geedubs/teensytrigger/pics/IMG_5148.JPG

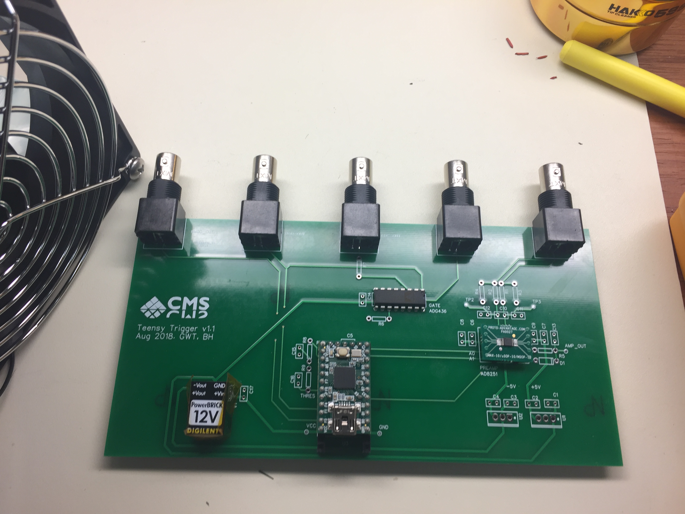
pics/IMG_5148.JPG
