geedubs/teensytrigger/pics/ringdowns.jpg

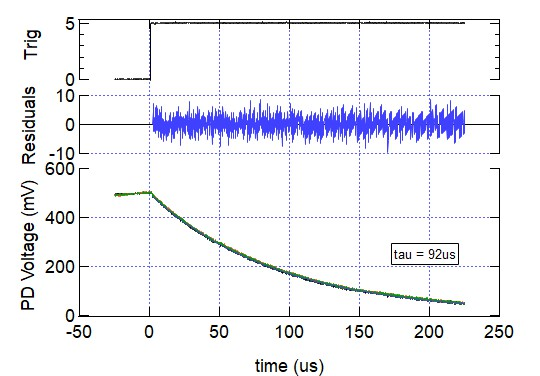
pics/ringdowns.jpg
