geedubs/teensytrigger/pics/top.PNG

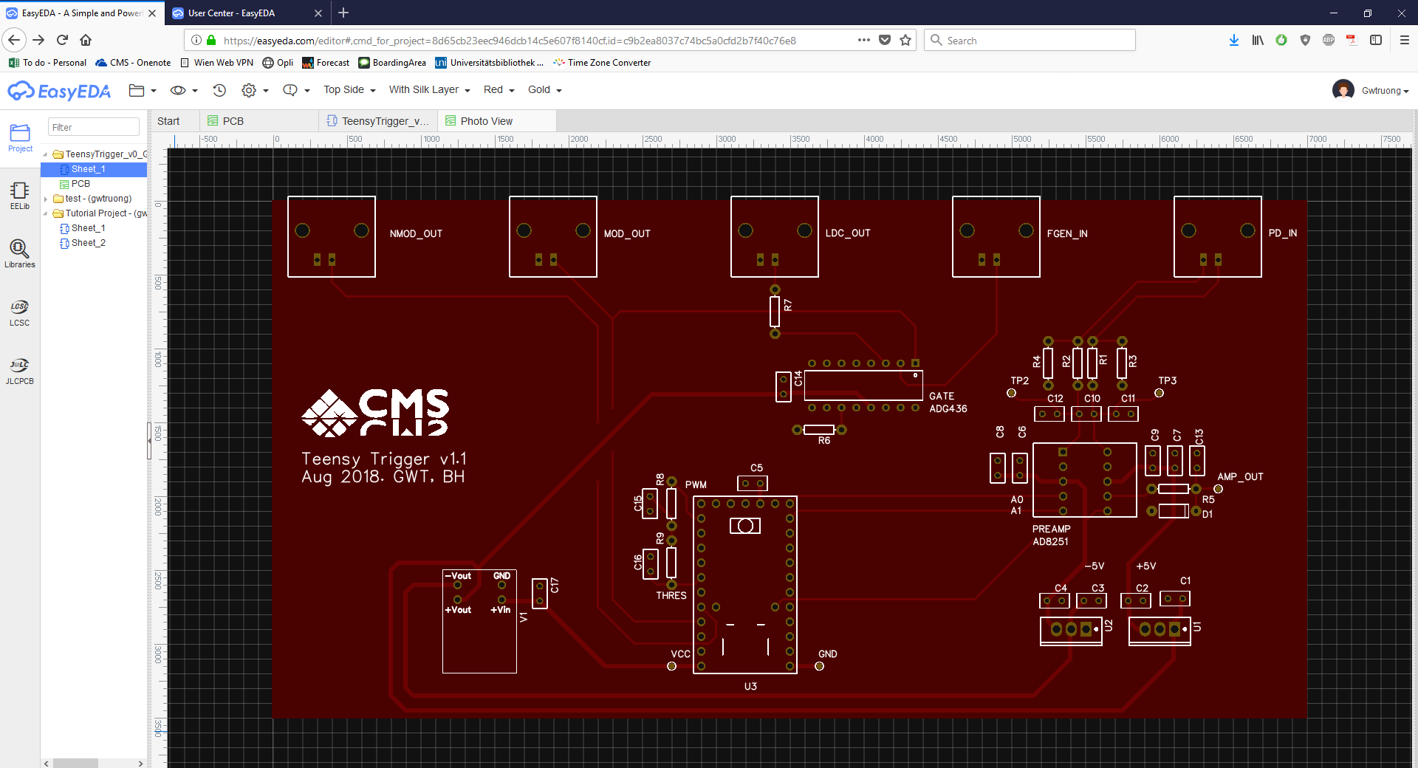
pics/top.PNG
