geedubs/teensytrigger/hardware/BOM.xlsx

QTY | UNIT PRICE | TOTAL PRICE | DESCRIPTION | VENDOR
5 | $2.96 | $14.81 | Custom PCB | See documentation
1 | $16.00 | $16.00 | Teensy 2.0 Microcontroller with pins | https://www.pjrc.com/store/teensy_pins.html
1 | $7.55 | $7.55 | ADG436BN SPDT | https://www.digikey.com/product-detail/en/analog-devices-inc/ADG436BNZ/ADG436BNZ-ND/820072
1 | $11.01 | $11.01 | AD8251 Instrument Amp | https://www.digikey.com/product-detail/en/analog-devices-inc/AD8251ARMZ/AD8251ARMZ-ND/1644799
1 | $19.11 | $19.11 | Digilent 12V PowerBRICK | https://www.digikey.com/product-detail/en/digilent-inc/410-293-A/1286-1106-ND/5730863
1 | $1.54 | $1.54 | LM7805 +5V Linear Reg | https://www.digikey.com/product-detail/en/texas-instruments/LM7805CT-NOPB/296-47192-ND/3901929
1 | $1.63 | $1.63 | LM7905 -5V Linear Reg | https://www.digikey.com/product-detail/en/texas-instruments/LM7905CT-NOPB/LM7905CTNS-NOPB-ND/6349
1 | $16.02 | $16.02 | Project box | https://www.digikey.com/products/en?keywords=HM617-ND
5 | $1.53 | $7.65 | PCB BNC connectors | https://www.digikey.com/products/en?keywords=WM5514-ND
1 | $3.95 | $3.95 | Micro-USB to USB-B panel mount | https://www.digikey.com/products/en?keywords=1528-1573-ND
1 | $4.09 | $4.09 | Surface mount to DIP adapter | https://www.digikey.com/product-detail/en/aries-electronics/LCQT-MSOP10/A881AR-ND/4754589
2 | $0.32 | $0.64 | 2POS Female Header | https://www.digikey.com/product-detail/en/sullins-connector-solutions/PPTC021LFBN-RC/S7000-ND/810142
2 | $0.45 | $0.90 | 4POS Female Header | https://www.digikey.com/product-detail/en/sullins-connector-solutions/PPPC041LFBN-RC/S7037-ND/810176
2 | $0.61 | $1.22 | 7POS Female Header | https://www.digikey.com/product-detail/en/sullins-connector-solutions/PPPC071LFBN-RC/S7040-ND/810179
1 | $0.47 | $0.47 | 5POS Female Header | https://www.digikey.com/product-detail/en/sullins-connector-solutions/PPTC051LFBN-RC/S6103-ND/807239
1 | $0.52 | $0.52 | 2x5pin dip socket | https://www.digikey.com/product-detail/en/on-shore-technology-inc/SA103000/ED3069-5-ND/3935340
3 | $0.63 | $1.89 | 2.2 uF cap (tant C1, C3, C17) | https://www.digikey.com/product-detail/en/avx-corporation/TAP225K016CCS/478-8819-ND/1471492
6 | $0.63 | $3.78 | 0.1 uF cap (tant C2, C4, C5, C6, C7, C14) | https://www.digikey.com/product-detail/en/avx-corporation/TAP104K035SRW/478-11084-1-ND/7536240
2 | $0.10 | $0.20 | 330 Ohm resistor (0.25W R6, R7) | https://www.digikey.com/product-detail/en/stackpole-electronics-inc/CF14JT330R/CF14JT330RCT-ND/1830338
2 | $0.10 | $0.20 | 3.3k resistor (0.25W R8 R9) | https://www.digikey.com/product-detail/en/stackpole-electronics-inc/CF14JT3K30/CF14JT3K30CT-ND/1830362
2 | $0.43 | $0.86 | 4.7 uF cap (tant C15, C16) | https://www.digikey.com/product-detail/en/avx-corporation/TAP475K016SRW/478-7381-1-ND/3660572
2 | $0.10 | $0.20 | 270k resistor (R1, R2) | https://www.digikey.com/product-detail/en/stackpole-electronics-inc/CF14JT270K/CF14JT270KCT-ND/1830409
2 | $0.10 | $0.20 | 1M resistor (R3, R4) | https://www.digikey.com/product-detail/en/stackpole-electronics-inc/CF14JT1M00/CF14JT1M00CT-ND/1830423
2 | $0.24 | $0.48 | 1 pF cap (ceramic, C11, C12) | https://www.digikey.com/product-detail/en/tdk-corporation/FG28C0G1H010CNT06/445-173463-1-ND/5812068
1 | $0.31 | $0.31 | 10 pF cap (ceramic C10) | https://www.digikey.com/product-detail/en/vishay-bc-components/S100K25SL0N63L6R/1246PH-ND/2356783
2 | $0.47 | $0.94 | 1 uF cap (tant C8, C9) | https://www.digikey.com/product-detail/en/avx-corporation/TAP105K035CCS/478-4168-ND/1212723
1 | $0.10 | $0.10 | 50 Ohm resistor (R5) | https://www.digikey.com/products/en/resistors/through-hole-resistors/53?k=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
1 | $0.25 | $0.25 | 4.7 nF cap (tant C13) | https://www.digikey.com/product-detail/en/vishay-bc-components/K472K15X7RF5TL2/BC1076CT-ND/286698
1 | $0.10 | $0.10 | small signal diode (D1) | https://www.digikey.com/product-detail/en/on-semiconductor/1N4448TR/1N4448CT-ND/458915
1 | $4.38 | $4.38 | USB Male A to Male B (3m) | https://www.digikey.com/product-detail/en/qualtek/3021013-10/Q367-ND/1531294
 |  | $106.19
