geedubs/teensytrigger/hardware/Schematic_TeensyTrigger-v1-1-GWT.pdf

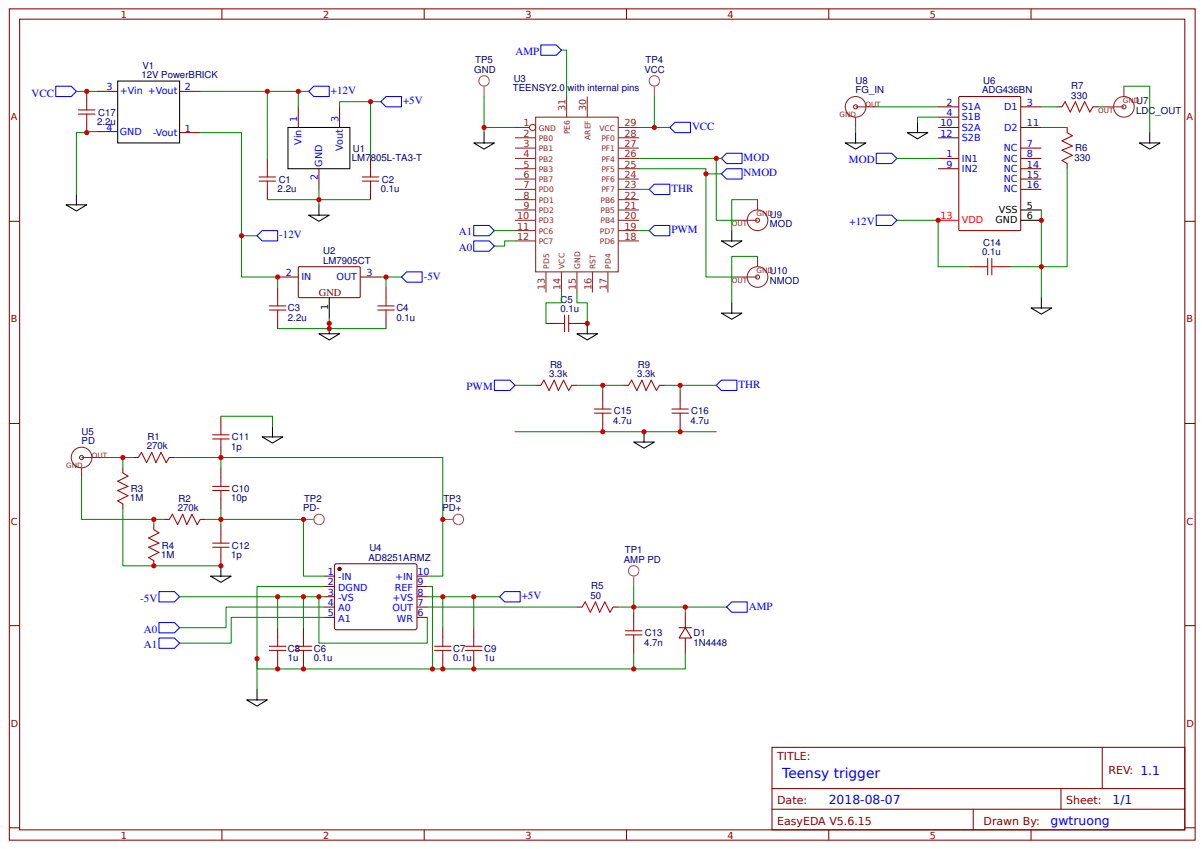
[picture p14: page 1]
